samuel-sjoden/drone-project/README.md

# Drone Project
**Attention**
This repository is deprecated and has since been migrated to codeberg: [link here](https://codeberg.org/drone-project)
