samuel-sjoden/drone-project/motor-driver/RP_Minimal/RP2350_QFN80.step

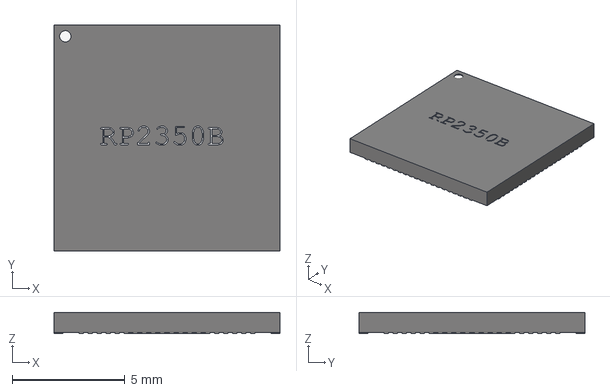
[picture p1: CAD file, 2026-03-13]
motor-driver/RP_Minimal/RP2350_QFN80.step
10.0 x 10.0 x 0.95 mm
