samuel-sjoden/drone-project/motor-driver/RP_Minimal/RP2350_QFN60.step

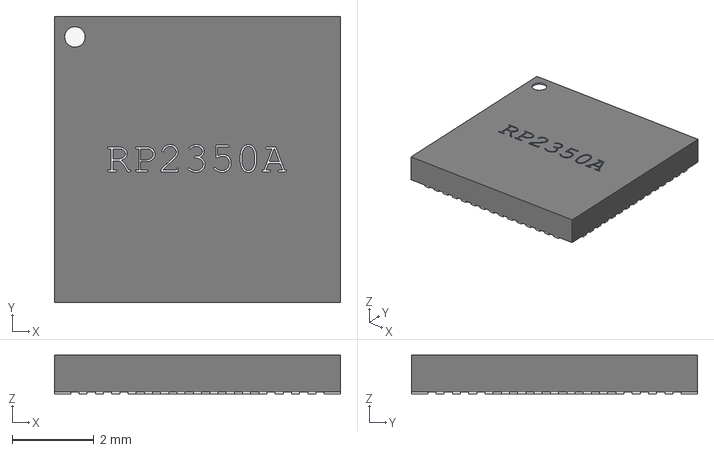
[picture p2: CAD file, 2026-03-13]
motor-driver/RP_Minimal/RP2350_QFN60.step
7.00 x 7.00 x 0.95 mm
