samuel-sjoden/drone-project/motor-driver/motor-driver.kicad_pcb

## KiCad design motor-driver/motor-driver.kicad_pcb (2026-04-12)

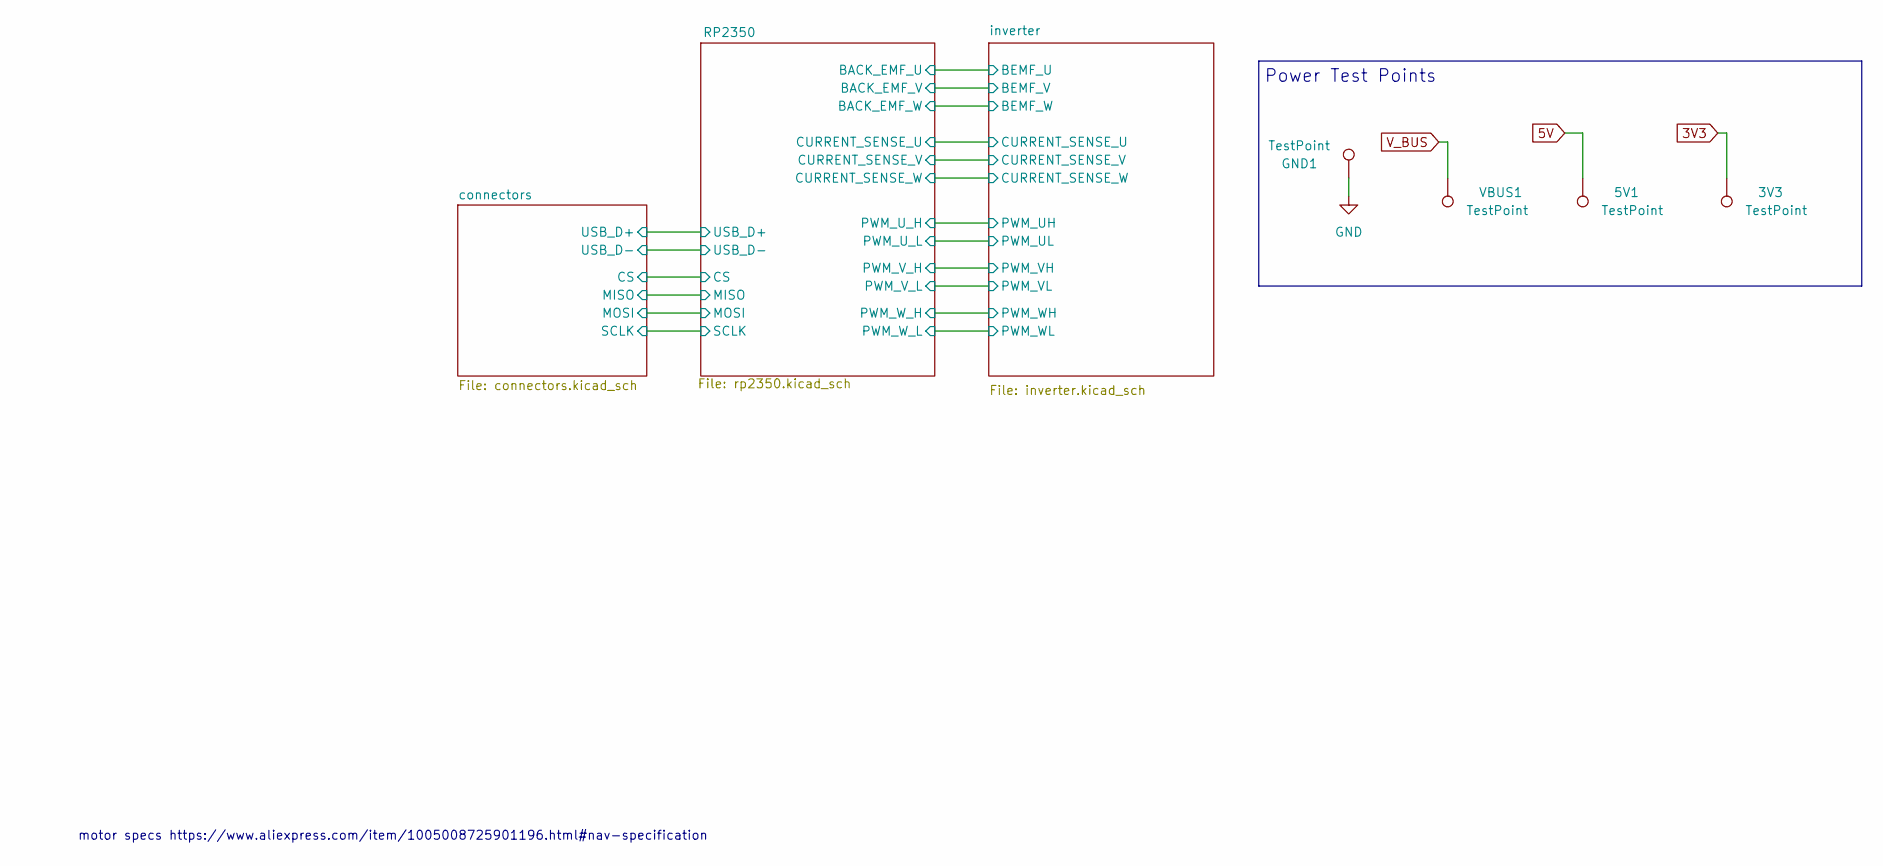
[picture p3: schematic motor-driver.kicad_sch]

Parts:
3V3, 5V1: TestPoint; TestPoint_THTPad_D1.0mm_Drill0.5mm
GND1: TestPoint; TestPoint_THTPad_D1.0mm_Drill0.5mm
VBUS1: TestPoint; TestPoint_THTPad_D1.0mm_Drill0.5mm

Connections:
3V3: 3V3.1; also elsewhere on the board
5V: 5V1.1; also elsewhere on the board
GND: GND1.1; also elsewhere on the board
V_BUS: VBUS1.1; also elsewhere on the board

Notes on the sheet:
motor specs https://www.aliexpress.com/item/1005008725901196.html#nav-specification
Power Test Points

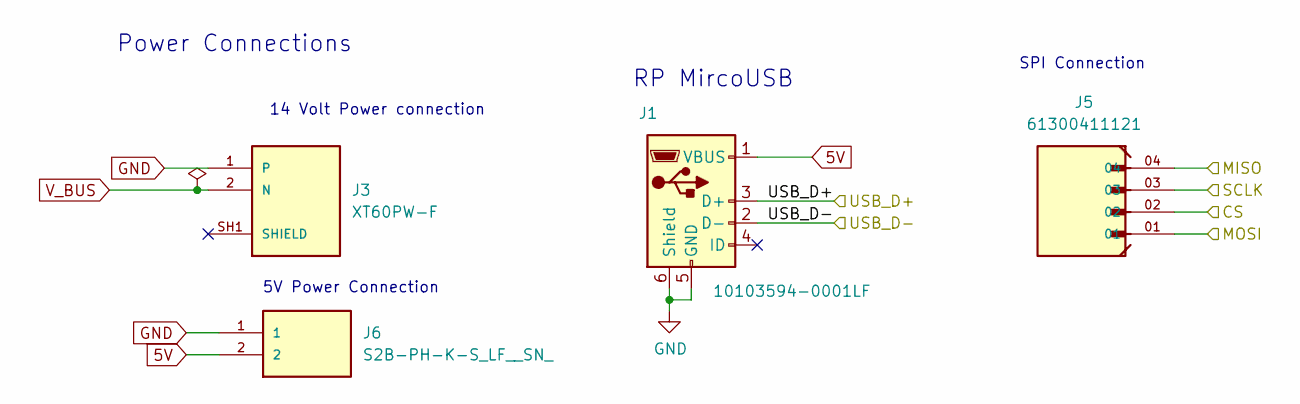
[picture p4: schematic connectors.kicad_sch]

Parts:
J1: 10103594-0001LF; USB_Micro-B_Amphenol_10103594-0001LF_Horizontal; MPN 10103594-0001LF
J3: XT60PW-F; AMASS_XT60PW-F; PARTREV 1.2
J5: 61300411121; WURTH_61300411121; MPN 61300411121
J6: S2B-PH-K-S_LF__SN_; JST_S2B-PH-K-S_LF__SN_

Connections:
5V: J1.1 (VBUS), J6.2; also elsewhere on the board
/RP2350/CS: J5.02; also elsewhere on the board
/RP2350/MISO: J5.04; also elsewhere on the board
/RP2350/MOSI: J5.01; also elsewhere on the board
/RP2350/SCLK: J5.03; also elsewhere on the board
/RP2350/USB_D+: J1.3 (D+); also elsewhere on the board
/RP2350/USB_D-: J1.2 (D-); also elsewhere on the board
GND: J1.5 (GND), J1.6 (Shield), J3.1, J6.1; also elsewhere on the board
V_BUS: J3.2 (N); also elsewhere on the board

Notes on the sheet:
Power Connections
14 Volt Power connection
5V Power Connection
SPI Connection
RP MircoUSB

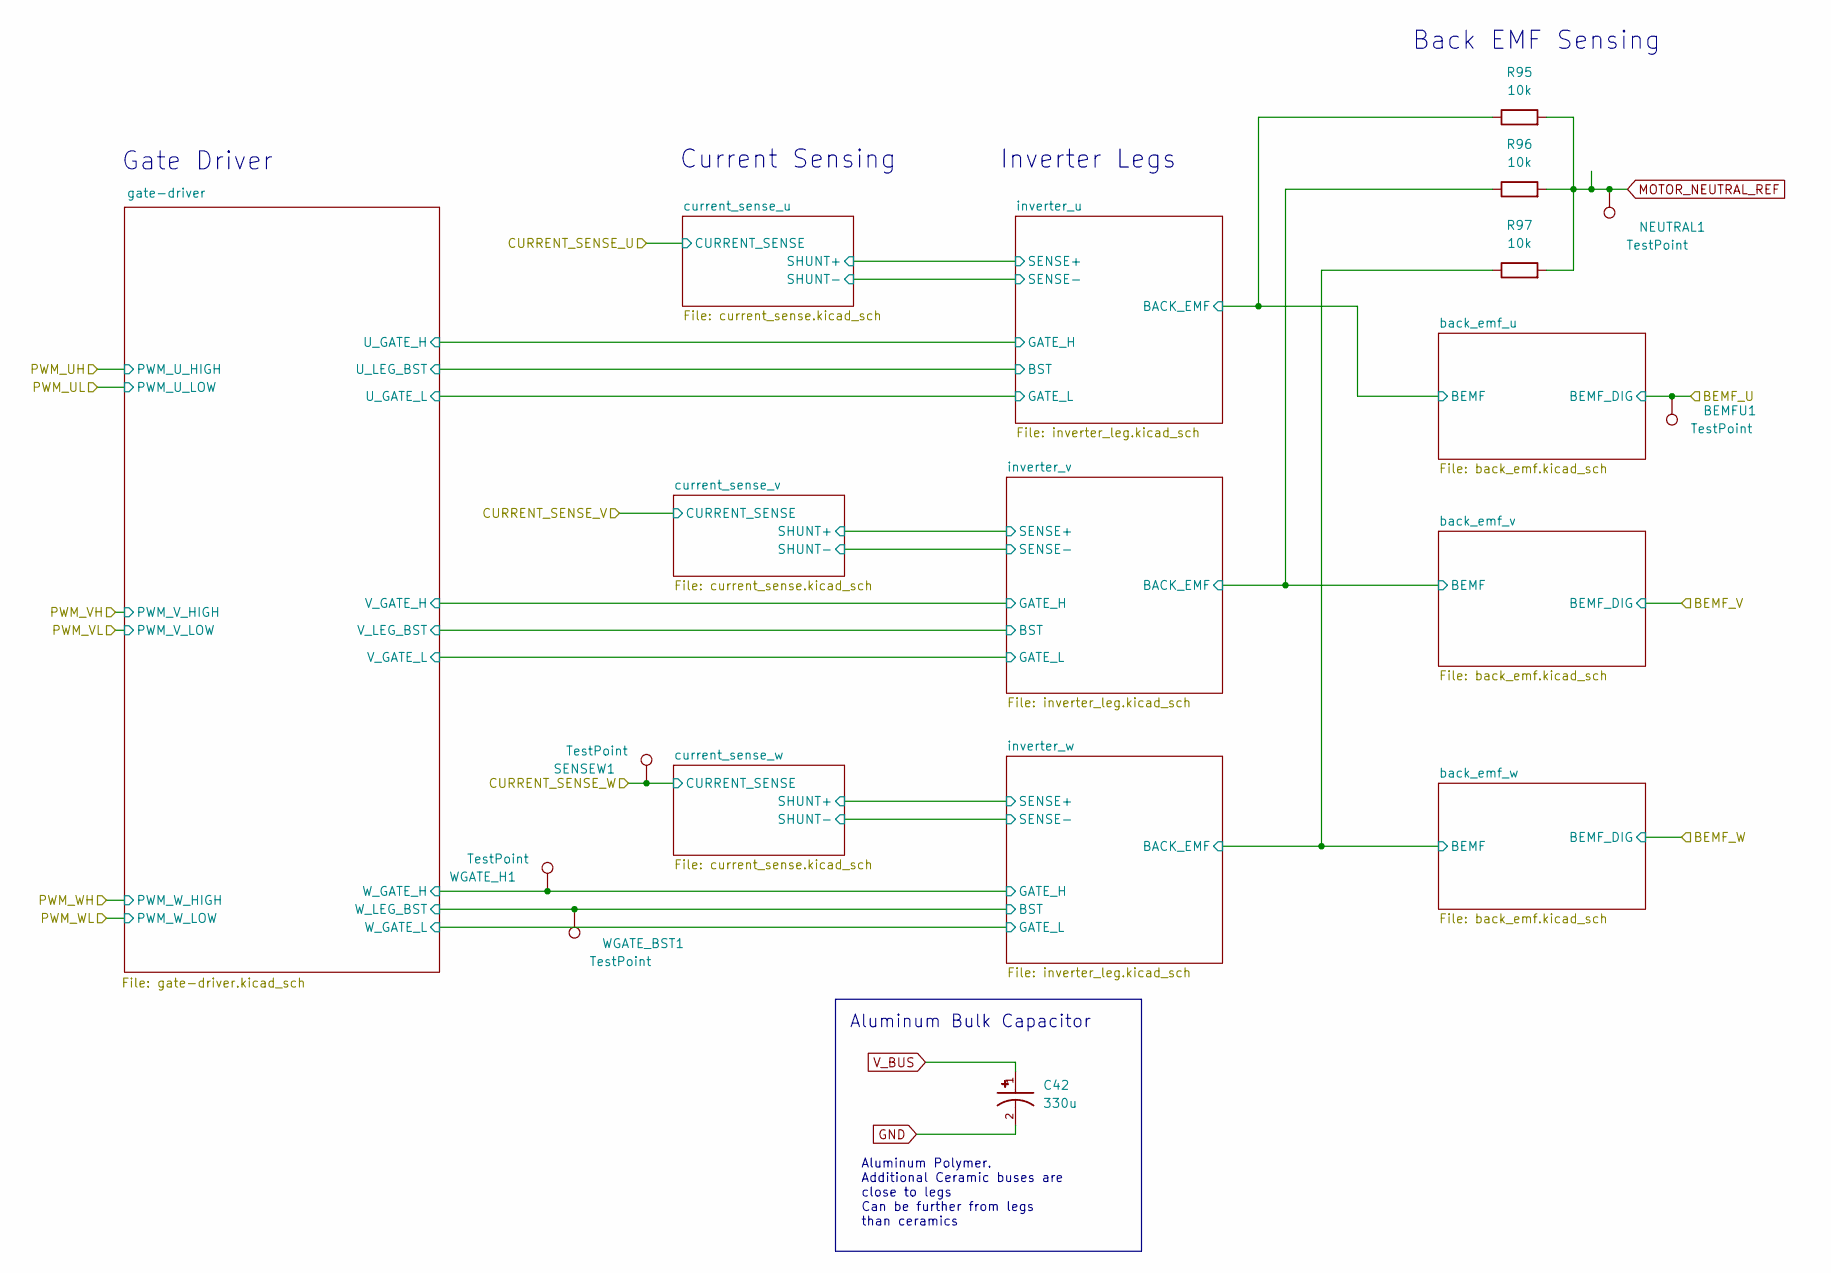
[picture p5: schematic inverter.kicad_sch]

Parts:
BEMFU1: TestPoint; TestPoint_THTPad_D1.0mm_Drill0.5mm
C42: 330u; CAPAE1030X1225N; PARTREV 8/5/2025
NEUTRAL1: TestPoint; TestPoint_THTPad_D1.0mm_Drill0.5mm
R95, R96, R97: 10k; R_0603_1608Metric; MPN RC0603FR-0710KL
SENSEW1: TestPoint; TestPoint_THTPad_D1.0mm_Drill0.5mm
WGATE_BST1: TestPoint; TestPoint_THTPad_D1.0mm_Drill0.5mm
WGATE_H1: TestPoint; TestPoint_THTPad_D1.0mm_Drill0.5mm

Connections:
/RP2350/BACK_EMF_U: BEMFU1.1; also elsewhere on the board
/RP2350/CURRENT_SENSE_W: SENSEW1.1; also elsewhere on the board
/inverter/gate-driver/W_GATE_H: WGATE_H1.1; also elsewhere on the board
/inverter/inverter_u/SHUNT_N: R95.1; also elsewhere on the board
/inverter/inverter_v/SHUNT_N: R96.1; also elsewhere on the board
/inverter/inverter_w/SHUNT_N: R97.1; also elsewhere on the board
/inverter/inverter_w/SHUNT_P: WGATE_BST1.1; also elsewhere on the board
GND: C42.2; also elsewhere on the board
MOTOR_NEUTRAL_REF: NEUTRAL1.1, R95.2, R96.2, R97.2; also elsewhere on the board
V_BUS: C42.1; also elsewhere on the board

Notes on the sheet:
Back EMF Sensing
Current Sensing
Gate Driver
Aluminum Bulk Capacitor
Aluminum Polymer. Additional Ceramic buses are close to legs Can be further from legs than ceramics
Inverter Legs

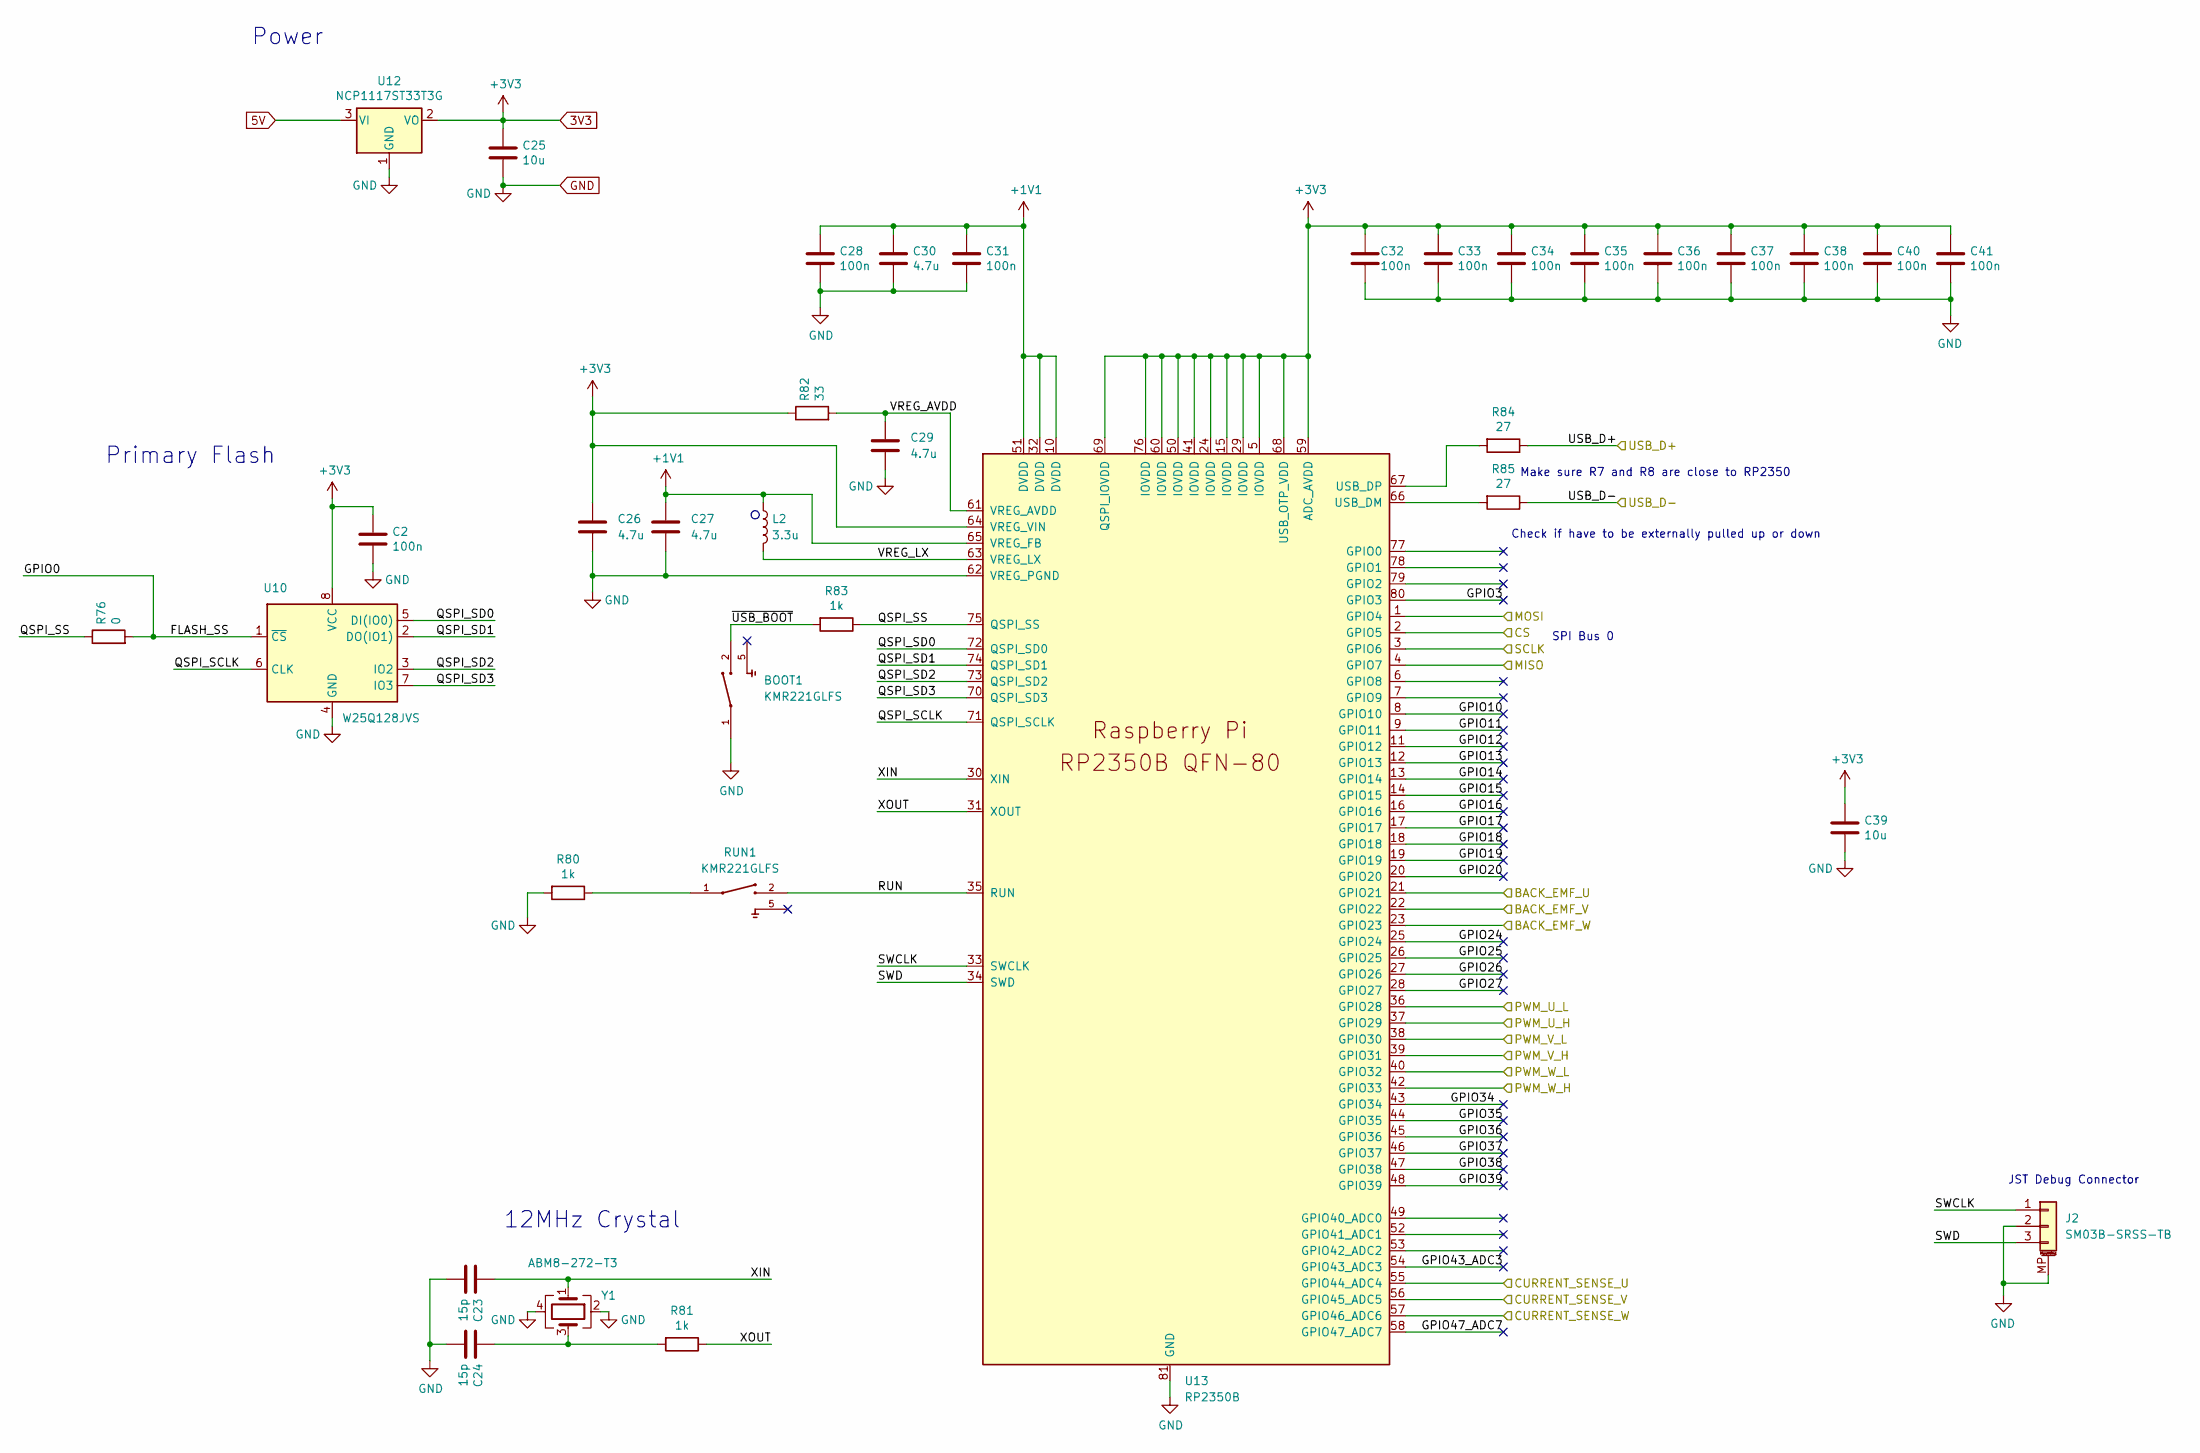
[picture p6: schematic rp2350.kicad_sch, RP2350B QFN80 Minimal Design Example]

Parts:
BOOT1: KMR221GLFS; SW_KMR221GLFS
C2: 100n; C_0603_1608Metric; MPN C0402C104K4RACTU
C23, C24: 15p; C_0402_1005Metric; MPN GJM1555C1H150GB01D
C25, C39: 10u; C_0603_1608Metric; MPN LMK107BBJ106MALT
C26, C27, C29, C30: 4.7u; C_0402_1005Metric; MPN CL05A475MP5NRNC
C28, C31, C32, C33, C34, C35, C36, C37, C38, C40, C41: 100n; C_0402_1005Metric; MPN C0402C104K4RACTU
J2: SM03B-SRSS-TB; JST_SH_SM03B-SRSS-TB_1x03-1MP_P1.00mm_Horizontal; MPN SM03B-SRSS-TB
L2: 3.3u; L_Cenker_CKCS201610; MPN AOTA-B201610S3R3-101-T
R76: 0; R_0603_1608Metric; MPN RC0402JR-070RL
R80, R81, R83: 1k; R_0402_1005Metric; MPN RC0402FR-071KL
R82: 33; R_0402_1005Metric; MPN RC0402JR-0733RL
R84, R85: 27; R_0402_1005Metric; MPN RC0402JR-0727RL
RUN1: KMR221GLFS; SW_KMR221GLFS
U10: W25Q128JVS; SOIC-8_5.23x5.23mm_P1.27mm
U12: NCP1117ST33T3G; SOT-223-3_TabPin2; MPN NCP1117ST33T3G
U13: RP2350B; RP2350-QFN-80-1EP_10x10_P0.4mm_EP3.4x3.4mm_ThermalVias; MPN SC1510-A4
Y1: ABM8-272-T3; Crystal_SMD_3225-4Pin_3.2x2.5mm; MPN ABM8-272-T3

Connections:
3V3: C2.1, C25.1, C26.1, C32.1, C33.1, C34.1, C35.1, C36.1, C37.1, C38.1, C39.1, C40.1, C41.1, R82.1, U10.8 (VCC), U12.2 (VO), U13.5 (IOVDD), U13.15 (IOVDD), U13.24 (IOVDD), U13.29 (IOVDD), U13.41 (IOVDD), U13.50 (IOVDD), U13.59 (ADC_AVDD), U13.60 (IOVDD), U13.64 (VREG_VIN), U13.68 (USB_OTP_VDD), U13.69 (QSPI_IOVDD), U13.76 (IOVDD); also elsewhere on the board
5V: U12.3 (VI); also elsewhere on the board
+1V1: C27.1, C28.1, C30.1, C31.1, L2.1, U13.10 (DVDD), U13.32 (DVDD), U13.51 (DVDD), U13.65 (VREG_FB)
/RP2350/BACK_EMF_U: U13.21 (GPIO21); also elsewhere on the board
/RP2350/BACK_EMF_V: U13.22 (GPIO22); also elsewhere on the board
/RP2350/BACK_EMF_W: U13.23 (GPIO23); also elsewhere on the board
/RP2350/CS: U13.2 (GPIO5); also elsewhere on the board
/RP2350/CURRENT_SENSE_U: U13.55 (GPIO44_ADC4); also elsewhere on the board
/RP2350/CURRENT_SENSE_V: U13.56 (GPIO45_ADC5); also elsewhere on the board
/RP2350/CURRENT_SENSE_W: U13.57 (GPIO46_ADC6); also elsewhere on the board
/RP2350/FLASH_SS: R76.2, U10.1 (~CS)
/RP2350/GPIO3: U13.80 (GPIO3)
/RP2350/GPIO10: U13.8 (GPIO10)
/RP2350/GPIO11: U13.9 (GPIO11)
/RP2350/GPIO12: U13.11 (GPIO12)
/RP2350/GPIO13: U13.12 (GPIO13)
/RP2350/GPIO14: U13.13 (GPIO14)
/RP2350/GPIO15: U13.14 (GPIO15)
/RP2350/GPIO16: U13.16 (GPIO16)
/RP2350/GPIO17: U13.17 (GPIO17)
/RP2350/GPIO18: U13.18 (GPIO18)
/RP2350/GPIO19: U13.19 (GPIO19)
/RP2350/GPIO20: U13.20 (GPIO20)
/RP2350/GPIO24: U13.25 (GPIO24)
/RP2350/GPIO25: U13.26 (GPIO25)
/RP2350/GPIO26: U13.27 (GPIO26)
/RP2350/GPIO27: U13.28 (GPIO27)
/RP2350/GPIO34: U13.43 (GPIO34)
/RP2350/GPIO35: U13.44 (GPIO35)
/RP2350/GPIO36: U13.45 (GPIO36)
/RP2350/GPIO37: U13.46 (GPIO37)
/RP2350/GPIO38: U13.47 (GPIO38)
/RP2350/GPIO39: U13.48 (GPIO39)
/RP2350/GPIO43_ADC3: U13.54 (GPIO43_ADC3)
/RP2350/GPIO47_ADC7: U13.58 (GPIO47_ADC7)
/RP2350/MISO: U13.4 (GPIO7); also elsewhere on the board
/RP2350/MOSI: U13.1 (GPIO4); also elsewhere on the board
/RP2350/PWM_U_H: U13.37 (GPIO29); also elsewhere on the board
/RP2350/PWM_U_L: U13.36 (GPIO28); also elsewhere on the board
/RP2350/PWM_V_H: U13.39 (GPIO31); also elsewhere on the board
/RP2350/PWM_V_L: U13.38 (GPIO30); also elsewhere on the board
/RP2350/PWM_W_H: U13.42 (GPIO33); also elsewhere on the board
/RP2350/PWM_W_L: U13.40 (GPIO32); also elsewhere on the board
/RP2350/QSPI_SCLK: U10.6 (CLK), U13.71 (QSPI_SCLK)
/RP2350/QSPI_SD0: U10.5 (DI(IO0)), U13.72 (QSPI_SD0)
/RP2350/QSPI_SD1: U10.2 (DO(IO1)), U13.74 (QSPI_SD1)
/RP2350/QSPI_SD2: U10.3 (IO2), U13.73 (QSPI_SD2)
/RP2350/QSPI_SD3: U10.7 (IO3), U13.70 (QSPI_SD3)
/RP2350/QSPI_SS: R76.1, R83.1, U13.75 (QSPI_SS)
/RP2350/RUN: RUN1.2, RUN1.3, U13.35 (RUN)
/RP2350/SCLK: U13.3 (GPIO6); also elsewhere on the board
/RP2350/SWCLK: J2.1, U13.33 (SWCLK)
/RP2350/SWD: J2.3, U13.34 (SWD)
/RP2350/USB_D+: R84.1; also elsewhere on the board
/RP2350/USB_D-: R85.1; also elsewhere on the board
/RP2350/VREG_AVDD: C29.1, R82.2, U13.61 (VREG_AVDD)
/RP2350/VREG_LX: L2.2, U13.63 (VREG_LX)
/RP2350/XIN: C23.1, U13.30 (XIN), Y1.1
/RP2350/XOUT: R81.1, U13.31 (XOUT)
/RP2350/~USB_BOOT: BOOT1.2, BOOT1.3, R83.2
GND: BOOT1.1, BOOT1.4, C2.2, C23.2, C24.2, C25.2, C26.2, C27.2, C28.2, C29.2, C30.2, C31.2, C32.2, C33.2, C34.2, C35.2, C36.2, C37.2, C38.2, C39.2, C40.2, C41.2, J2.2, J2.MP (MountPin), R80.2, U10.4 (GND), U12.1 (GND), U13.62 (VREG_PGND), U13.81 (GND), Y1.2, Y1.4; also elsewhere on the board
unnamed: C24.1, R81.2, Y1.3
unnamed: R80.1, RUN1.1, RUN1.4
unnamed: R85.2, U13.66 (USB_DM)
unnamed: R84.2, U13.67 (USB_DP)

Notes on the sheet:
12MHz Crystal
Primary Flash
Check if have to be externally pulled up or down
JST Debug Connector
Make sure R7 and R8 are close to RP2350
Power
SPI Bus 0

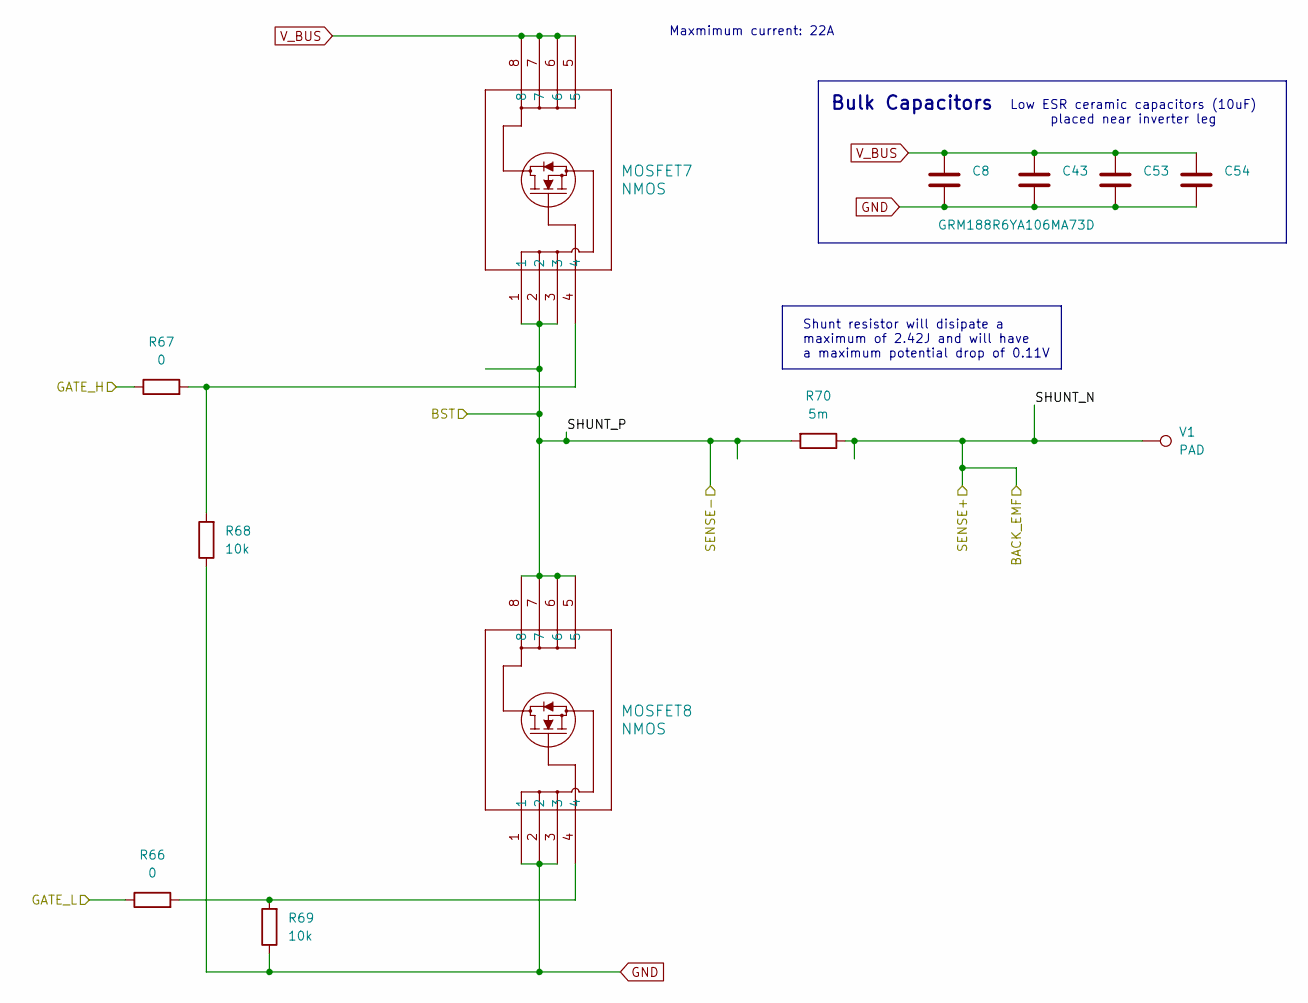
[picture p7: schematic inverter_leg.kicad_sch, Inverter Leg]

Parts:
C8, C43, C53, C54: GRM188R6YA106MA73D; C_0603_1608Metric; MPN GRM188R6YA106MA73D
MOSFET7, MOSFET8: NMOS; DFN5X6_8L_EP1_P_AOS; MPN AON6512
R66, R67: 0; R_0603_1608Metric; MPN RC0603FR-0722RL
R68, R69: 10k; R_0603_1608Metric; MPN RC0603FR-0710KL
R70: 5m; R_2512_6332Metric; MPN CSSU2512FT5L00
V1: PAD; TestPoint_Pad_4.0x4.0mm

Connections:
/inverter/gate-driver/V_GATE_H: R67.1; also elsewhere on the board
/inverter/gate-driver/V_GATE_L: R66.1; also elsewhere on the board
/inverter/inverter_v/SHUNT_N: R70.1, V1.1; also elsewhere on the board
/inverter/inverter_v/SHUNT_P: MOSFET7.1, MOSFET7.2, MOSFET7.3, MOSFET8.5, MOSFET8.6, MOSFET8.7, MOSFET8.8, R70.2; also elsewhere on the board
GND: C8.2, C43.2, C53.2, C54.2, MOSFET8.1, MOSFET8.2, MOSFET8.3, R68.1, R69.1; also elsewhere on the board
unnamed: MOSFET7.4, R67.2, R68.2
unnamed: MOSFET8.4, R66.2, R69.2
V_BUS: C8.1, C43.1, C53.1, C54.1, MOSFET7.5, MOSFET7.6, MOSFET7.7, MOSFET7.8; also elsewhere on the board

Parts of its further copies:
C55, C56, C57, C58, C59, C60, C61, C62: GRM188R6YA106MA73D; C_0603_1608Metric; MPN GRM188R6YA106MA73D
MOSFET1, MOSFET2, MOSFET9, MOSFET10: NMOS; DFN5X6_8L_EP1_P_AOS; MPN AON6512
R6, R27, R71, R86: 0; R_0603_1608Metric; MPN RC0603FR-0722RL
R26, R28, R87, R88: 10k; R_0603_1608Metric; MPN RC0603FR-0710KL
R29, R89: 5m; R_2512_6332Metric; MPN CSSU2512FT5L00
U1: PAD; TestPoint_Pad_4.0x4.0mm
W1: PAD; TestPoint_Pad_4.0x4.0mm

Connections of its further copies:
/inverter/gate-driver/U_GATE_H: R6.1; also elsewhere on the board
/inverter/gate-driver/U_GATE_L: R27.1; also elsewhere on the board
/inverter/gate-driver/W_GATE_H: R86.1; also elsewhere on the board
/inverter/gate-driver/W_GATE_L: R71.1; also elsewhere on the board
/inverter/inverter_u/SHUNT_N: R29.1, U1.1; also elsewhere on the board
/inverter/inverter_u/SHUNT_P: MOSFET1.1, MOSFET1.2, MOSFET1.3, MOSFET2.5, MOSFET2.6, MOSFET2.7, MOSFET2.8, R29.2; also elsewhere on the board
/inverter/inverter_w/SHUNT_N: R89.1, W1.1; also elsewhere on the board
/inverter/inverter_w/SHUNT_P: MOSFET9.1, MOSFET9.2, MOSFET9.3, MOSFET10.5, MOSFET10.6, MOSFET10.7, MOSFET10.8, R89.2; also elsewhere on the board
GND: C55.2, C56.2, C57.2, C58.2, C59.2, C60.2, C61.2, C62.2, MOSFET2.1, MOSFET2.2, MOSFET2.3, MOSFET10.1, MOSFET10.2, MOSFET10.3, R26.1, R28.1, R87.1, R88.1; also elsewhere on the board
unnamed: MOSFET1.4, R6.2, R26.2
unnamed: MOSFET2.4, R27.2, R28.2
unnamed: MOSFET9.4, R86.2, R87.2
unnamed: MOSFET10.4, R71.2, R88.2
V_BUS: C55.1, C56.1, C57.1, C58.1, C59.1, C60.1, C61.1, C62.1, MOSFET1.5, MOSFET1.6, MOSFET1.7, MOSFET1.8, MOSFET9.5, MOSFET9.6, MOSFET9.7, MOSFET9.8; also elsewhere on the board

Notes on the sheet:
Maxmimum current: 22A
Bulk Capacitors
Shunt resistor will disipate a maximum of 2.42J and will have a maximum potential drop of 0.11V
Low ESR ceramic capacitors (10uF) placed near inverter leg

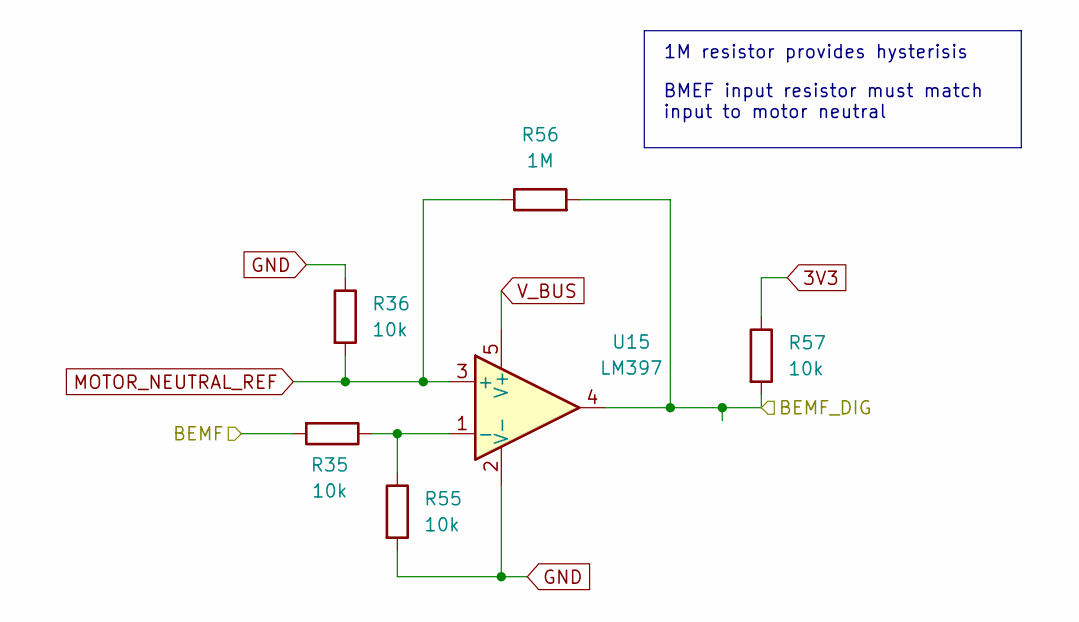
[picture p8: schematic back_emf.kicad_sch]

Parts:
R35, R36, R55, R57: 10k; R_0603_1608Metric; MPN RC0603FR-0710KL
R56: 1M; R_0603_1608Metric; MPN RC0603FR-071ML
U15: LM397; SOT-23-5; MPN LM397MFX/NOPB

Connections:
3V3: R57.1; also elsewhere on the board
/RP2350/BACK_EMF_V: R56.2, R57.2, U15.4; also elsewhere on the board
/inverter/inverter_v/SHUNT_N: R35.2; also elsewhere on the board
GND: R36.1, R55.2, U15.2 (V-); also elsewhere on the board
MOTOR_NEUTRAL_REF: R36.2, R56.1, U15.3 (+); also elsewhere on the board
unnamed: R35.1, R55.1, U15.1 (-)
V_BUS: U15.5 (V+); also elsewhere on the board

Parts of its further copies:
R30, R31, R32, R34, R90, R91, R92, R94: 10k; R_0603_1608Metric; MPN RC0603FR-0710KL
R33, R93: 1M; R_0603_1608Metric; MPN RC0603FR-071ML
U14, U16: LM397; SOT-23-5; MPN LM397MFX/NOPB

Connections of its further copies:
3V3: R34.1, R94.1; also elsewhere on the board
/RP2350/BACK_EMF_U: R33.2, R34.2, U14.4; also elsewhere on the board
/RP2350/BACK_EMF_W: R93.2, R94.2, U16.4; also elsewhere on the board
/inverter/inverter_u/SHUNT_N: R30.2; also elsewhere on the board
/inverter/inverter_w/SHUNT_N: R90.2; also elsewhere on the board
GND: R31.1, R32.2, R91.1, R92.2, U14.2 (V-), U16.2 (V-); also elsewhere on the board
MOTOR_NEUTRAL_REF: R31.2, R33.1, R91.2, R93.1, U14.3 (+), U16.3 (+); also elsewhere on the board
unnamed: R30.1, R32.1, U14.1 (-)
unnamed: R90.1, R92.1, U16.1 (-)
V_BUS: U14.5 (V+), U16.5 (V+); also elsewhere on the board

Notes on the sheet:
1M resistor provides hysterisis
BMEF input resistor must match input to motor neutral

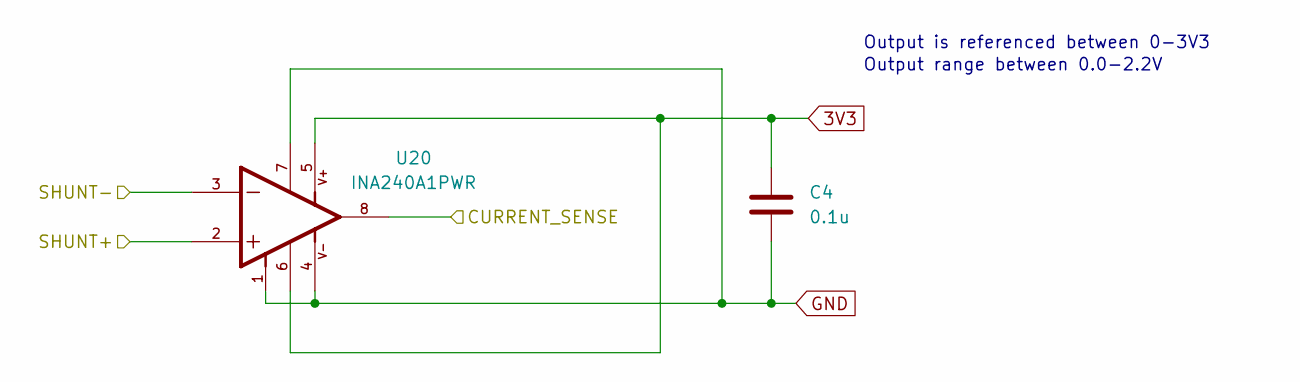
[picture p9: schematic current_sense.kicad_sch]

Parts:
C4: 0.1u; C_0603_1608Metric; MPN C0603C104K5RACTU
U20: INA240A1PWR; SOP65P640X120-8N; PARTREV C

Connections:
3V3: C4.1, U20.5, U20.6; also elsewhere on the board
/RP2350/CURRENT_SENSE_V: U20.8; also elsewhere on the board
/inverter/inverter_v/SHUNT_N: U20.2; also elsewhere on the board
/inverter/inverter_v/SHUNT_P: U20.3; also elsewhere on the board
GND: C4.2, U20.1, U20.4, U20.7; also elsewhere on the board

Parts of its further copies:
C3, C5: 0.1u; C_0603_1608Metric; MPN C0603C104K5RACTU
U19, U21: INA240A1PWR; SOP65P640X120-8N; PARTREV C

Connections of its further copies:
3V3: C3.1, C5.1, U19.5, U19.6, U21.5, U21.6; also elsewhere on the board
/RP2350/CURRENT_SENSE_U: U19.8; also elsewhere on the board
/RP2350/CURRENT_SENSE_W: U21.8; also elsewhere on the board
/inverter/inverter_u/SHUNT_N: U19.2; also elsewhere on the board
/inverter/inverter_u/SHUNT_P: U19.3; also elsewhere on the board
/inverter/inverter_w/SHUNT_N: U21.2; also elsewhere on the board
/inverter/inverter_w/SHUNT_P: U21.3; also elsewhere on the board
GND: C3.2, C5.2, U19.1, U19.4, U19.7, U21.1, U21.4, U21.7; also elsewhere on the board

Notes on the sheet:
Output is referenced between 0-3V3
Output range between 0.0-2.2V

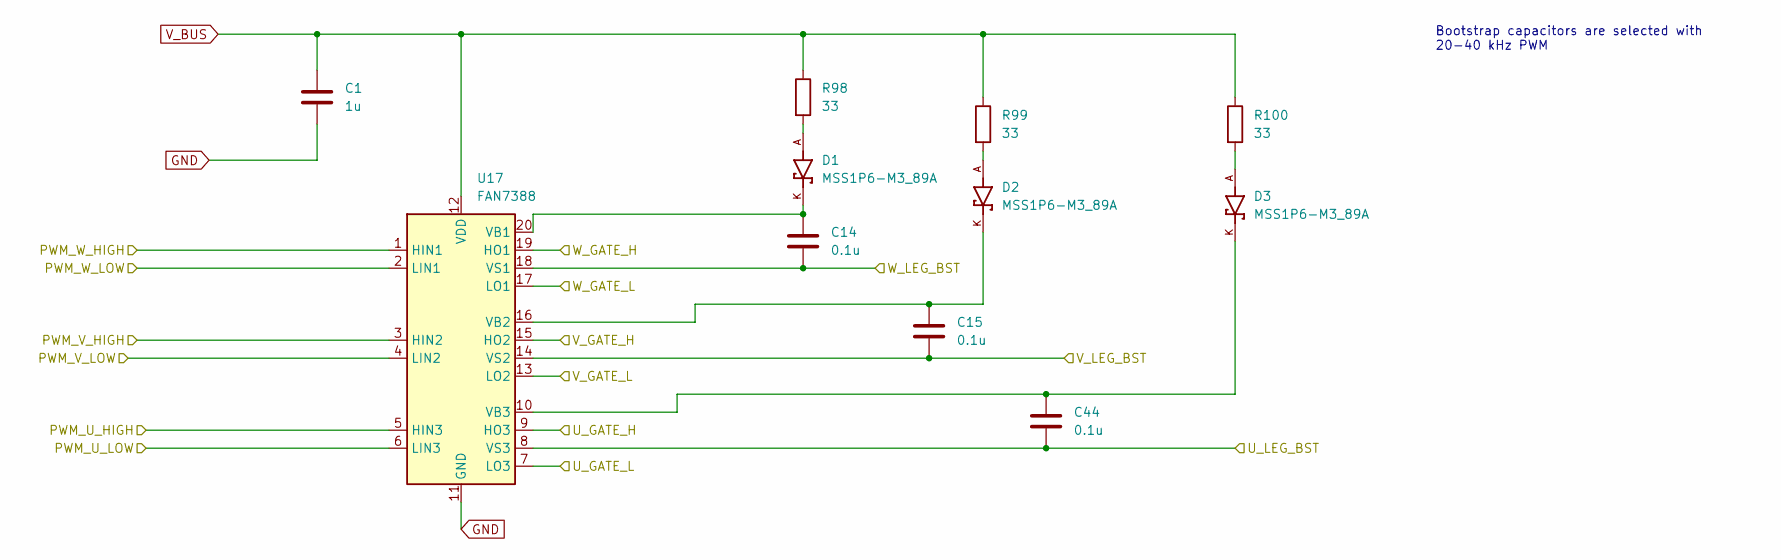
[picture p10: schematic gate-driver.kicad_sch]

Parts:
C1: 1u; C_0603_1608Metric; MPN C0603C105K4RACTU
C14, C15, C44: 0.1u; C_0603_1608Metric; MPN C0603C104K5RACTU
D1, D2, D3: MSS1P6-M3_89A; DIO_MSS1P6-M3_89A; PARTREV 03-Aug-2020
R98, R99, R100: 33; R_0603_1608Metric; MPN RC0603FR-0733RL
U17: FAN7388; SOIC-20W_7.5x12.8mm_P1.27mm; MPN FAN7388MX

Connections:
/RP2350/PWM_U_H: U17.5 (HIN3); also elsewhere on the board
/RP2350/PWM_U_L: U17.6 (LIN3); also elsewhere on the board
/RP2350/PWM_V_H: U17.3 (HIN2); also elsewhere on the board
/RP2350/PWM_V_L: U17.4 (LIN2); also elsewhere on the board
/RP2350/PWM_W_H: U17.1 (HIN1); also elsewhere on the board
/RP2350/PWM_W_L: U17.2 (LIN1); also elsewhere on the board
/inverter/gate-driver/U_GATE_H: U17.9 (HO3); also elsewhere on the board
/inverter/gate-driver/U_GATE_L: U17.7 (LO3); also elsewhere on the board
/inverter/gate-driver/V_GATE_H: U17.15 (HO2); also elsewhere on the board
/inverter/gate-driver/V_GATE_L: U17.13 (LO2); also elsewhere on the board
/inverter/gate-driver/W_GATE_H: U17.19 (HO1); also elsewhere on the board
/inverter/gate-driver/W_GATE_L: U17.17 (LO1); also elsewhere on the board
/inverter/inverter_u/SHUNT_P: C44.1, U17.8 (VS3); also elsewhere on the board
/inverter/inverter_v/SHUNT_P: C15.1, U17.14 (VS2); also elsewhere on the board
/inverter/inverter_w/SHUNT_P: C14.1, U17.18 (VS1); also elsewhere on the board
GND: C1.2, U17.11 (GND); also elsewhere on the board
unnamed: D1.A, R98.2
unnamed: D2.A, R99.2
unnamed: D3.A, R100.2
unnamed: C14.2, D1.K, U17.20 (VB1)
unnamed: C15.2, D2.K, U17.16 (VB2)
unnamed: C44.2, D3.K, U17.10 (VB3)
V_BUS: C1.1, R98.1, R99.1, R100.1, U17.12 (VDD); also elsewhere on the board

Notes on the sheet:
Bootstrap capacitors are selected with 20-40 kHz PWM

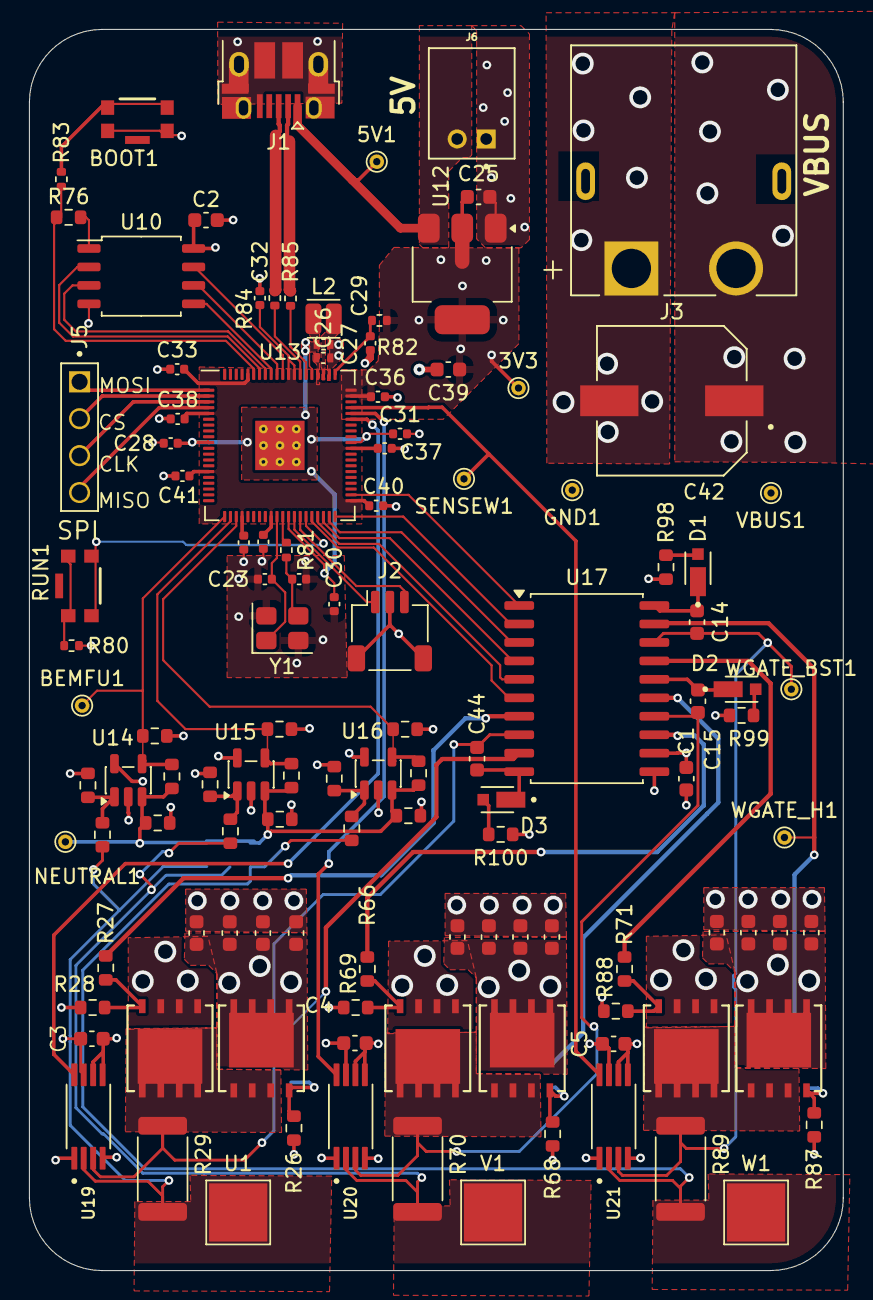
[picture p11: board motor-driver.kicad_pcb from above]

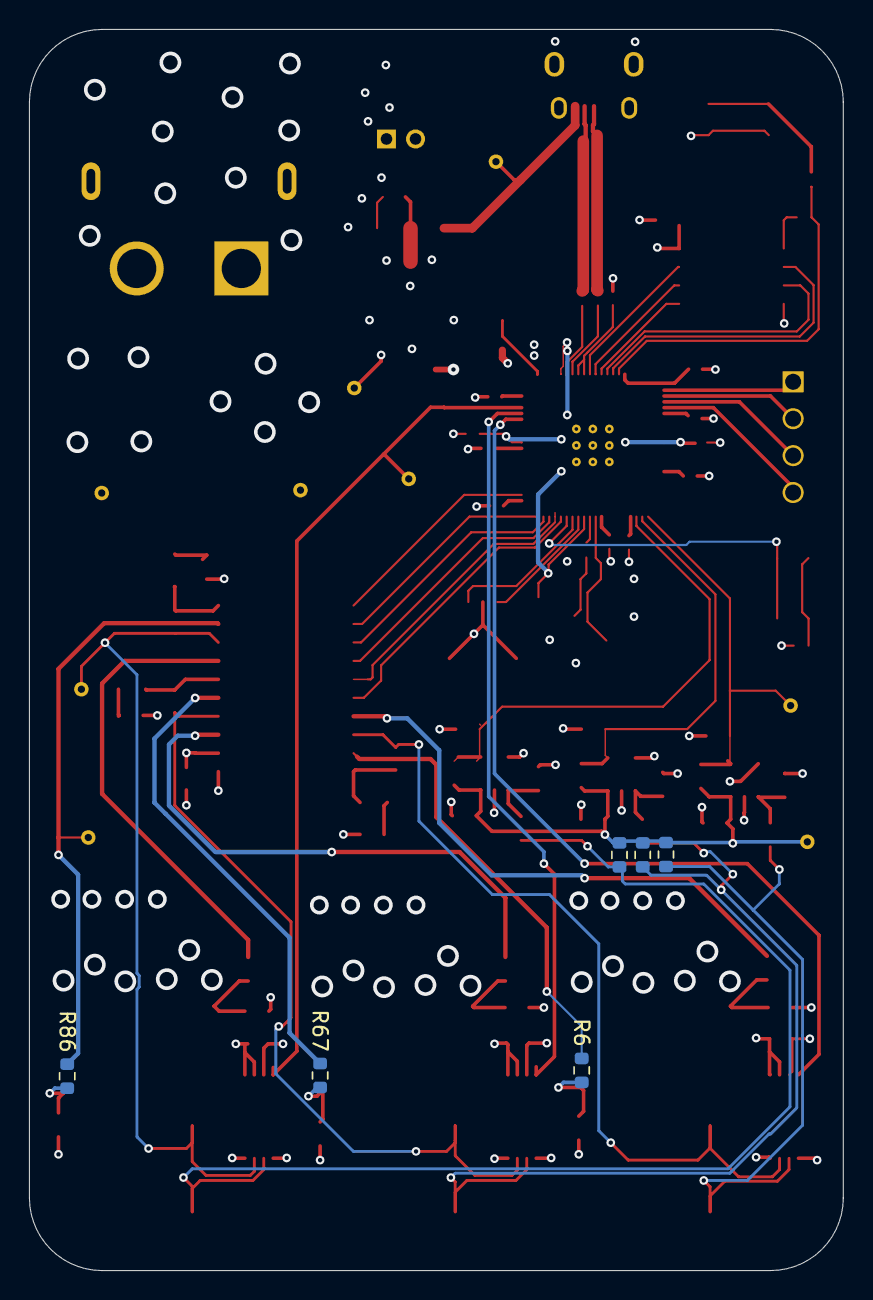
[picture p12: board motor-driver.kicad_pcb from below]

Board: 4 copper layers, 56.0 x 85.4 mm, 123 parts (6 on the bottom side), 70 nets.
