samuel-sjoden/drone-project/flight-controller/flight-controller.kicad_pcb

## KiCad design flight-controller/flight-controller.kicad_pcb (2026-04-12)

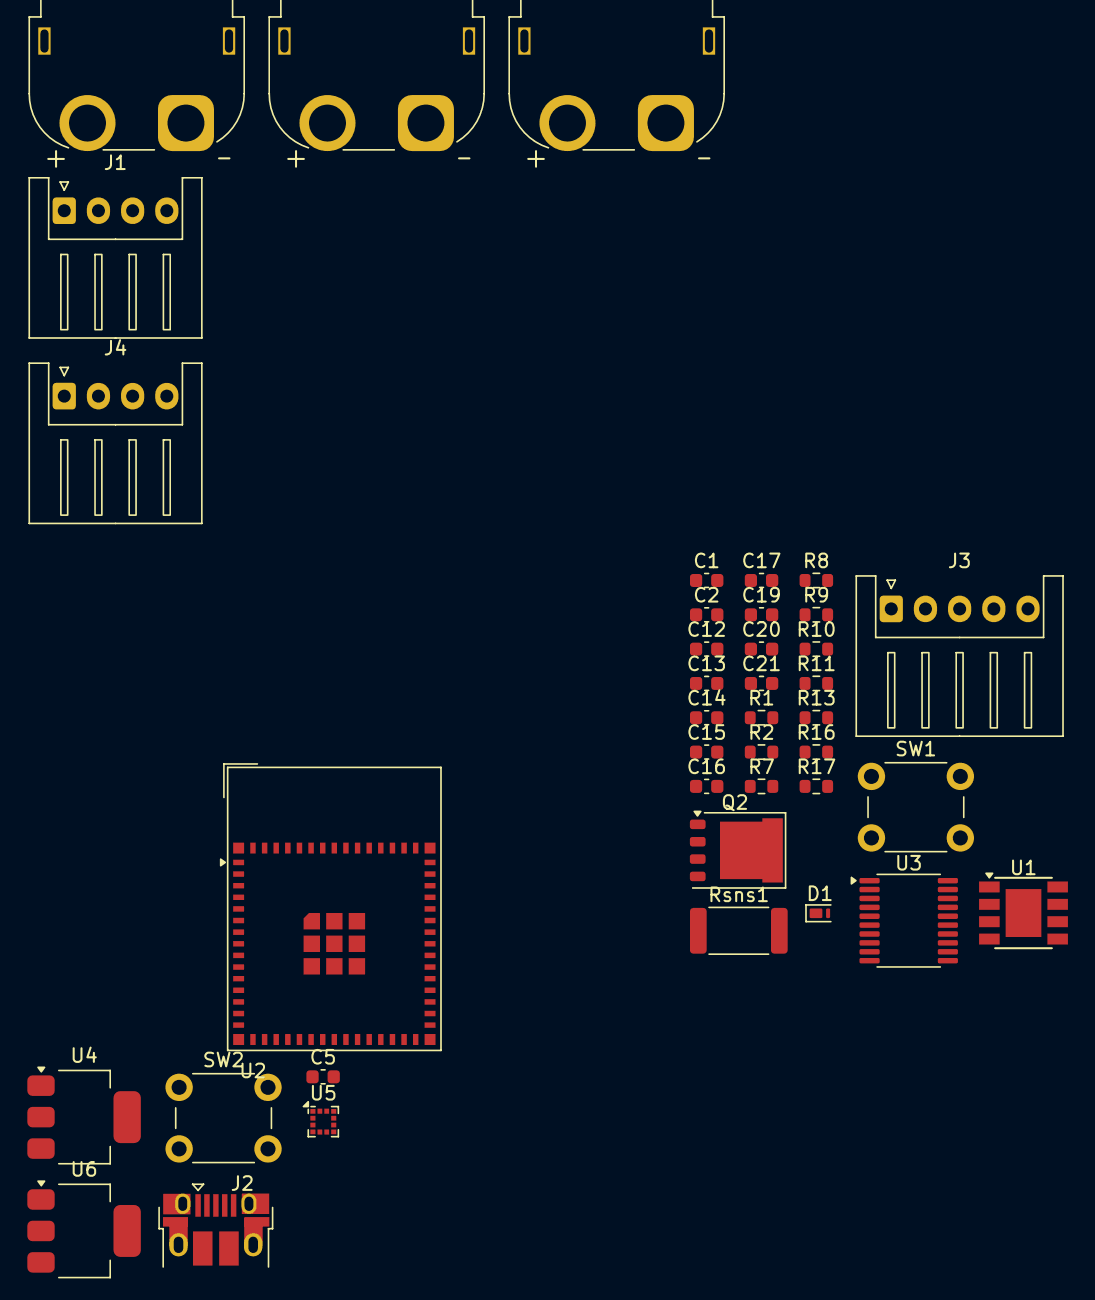
[picture p13: board flight-controller.kicad_pcb from above]

Board: 2 copper layers, 40 parts (0 on the bottom side), 35 nets, no tracks yet.

Parts:
C1, C12, C16, C17, C19, C20, C21: 1u; C_0603_1608Metric
C2, C5: 10u; C_0603_1608Metric
C13, C14, C15: 0.1u; C_0603_1608Metric
D1: PTVS18VZ1USK; Nexperia_DSN1608-2_1.6x0.8mm
J1: MD1_SPI; JST_XH_S4B-XH-A_1x04_P2.50mm_Horizontal
J2: USB_B_Micro; USB_Micro-B_Amphenol_10103594-0001LF_Horizontal
J3: Lipo JST; JST_XH_S5B-XH-A_1x05_P2.50mm_Horizontal
J4: MD2_SPI; JST_XH_S4B-XH-A_1x04_P2.50mm_Horizontal
J8: XT60PW-F; AMASS_XT60PW-F_1x02_P7.20mm_Horizontal
J9: MD1_15V; AMASS_XT60PW-F_1x02_P7.20mm_Horizontal
J10: MD2_15V; AMASS_XT60PW-F_1x02_P7.20mm_Horizontal
Q2: NMOS; PQFN-8-EP_6x5mm_P1.27mm_Generic
R1, R2, R9, R10, R11, R13, R16: 100; R_0603_1608Metric
R7: 1M; R_0603_1608Metric
R8, R17: 10k; R_0603_1608Metric
Rsns1: 5m; R_2512_6332Metric
SW1: SW_Push; SW_PUSH_6mm
SW2: RESET; SW_PUSH_6mm
U1: AP64500SP-13; Diodes_SO-8EP
U2: ESP32-S3-MINI-1; ESP32-S2-MINI-1
U3: BQ76920PW; TSSOP-20_4.4x6.5mm_P0.65mm
U4: NCP1117ST33T3G; SOT-223-3_TabPin2
U5: LIS2MDL; LGA-12_2x2mm_P0.5mm
U6: NCP1117-1.8_SOT223; SOT-223-3_TabPin2

Connections:
3V3: C5.1, U2.3 (3V3), U4.2 (VO)
5V: J2.1 (VBUS), U4.3 (VI), U6.3 (VI)
+1V8: U5.9 (Vdd), U5.10 (Vdd_IO), U6.2 (VO)
/BMS/15V: C12.1, D1.1 (K), J8.1, J9.1, J10.1, R1.1, U1.2 (VIN), U1.3 (EN), U3.9 (REGSRC)
/BMS/INT_BMS: U2.10 (IO6), U3.20 (ALERT)
/BMS/PWR_BTN: R8.1, R17.1, U2.5 (IO1), U3.6 (TS1)
/Flight_Controller/CS_MD1: J1.3, U2.31 (IO35)
/Flight_Controller/CS_MD2: J4.3, U2.32 (IO36)
/Flight_Controller/MISO: J1.1, J4.1, U2.17 (IO13)
/Flight_Controller/MOSI: J1.4, J4.4, U2.15 (IO11)
/Flight_Controller/SCL: U2.12 (IO8), U3.5 (SCL)
/Flight_Controller/SCLK: J1.2, J4.2, U2.16 (IO12)
/Flight_Controller/SDA: U2.13 (IO9), U3.4 (SDA)
GND: C1.2, C2.2, C12.2, C14.1, C15.2, C16.2, C17.1, J8.2 (N), R8.2, R11.1, Rsns1.1, U3.3 (VSS)
GND1: C5.2, D1.2 (A), J2.5 (GND), J2.SH (Shield), J9.2 (N), J10.2 (N), Q2.1 (D), SW2.1, U1.7 (GND), U2.1 (GND), U2.2 (GND), U2.42 (GND), U2.43 (GND), U2.46 (GND), U2.47 (GND), U2.48 (GND), U2.49 (GND), U2.50 (GND), U2.51 (GND), U2.52 (GND), U2.53 (GND), U2.54 (GND), U2.55 (GND), U2.56 (GND), U2.57 (GND), U2.58 (GND), U2.59 (GND), U2.60 (GND), U2.61 (GND), U2.62 (GND), U2.63 (GND), U2.64 (GND), U2.65 (GND), U4.1 (GND), U5.6 (GND), U5.8 (GND), U6.1 (GND)
unnamed: J2.3 (D+), U2.24 (USB_D+)
unnamed: J2.2 (D-), U2.23 (USB_D-)
unnamed: J3.1, R9.1
unnamed: J3.2, R10.1
unnamed: J3.3, R13.1
unnamed: J3.4, R2.1
unnamed: J3.5, R16.1
unnamed: Q2.2 (G), R7.1, U3.1 (DSG)
unnamed: Q2.3 (S), R7.2, Rsns1.2
unnamed: R17.2, SW1.1
unnamed: SW2.2, U2.45 (EN)
unnamed: C2.1, R1.2, U3.10 (BAT)
unnamed: C1.1, U3.7 (CAP1)
unnamed: C13.1, C14.2, U3.19 (SRN)
unnamed: C13.2, C15.1, R11.2, U3.18 (SRP)
unnamed: C17.2, R9.2, U3.17 (VC0)
unnamed: C16.1, C19.2, R10.2, SW1.2, U3.16 (VC1)
unnamed: C19.1, C20.2, R13.2, U3.15 (VC2)
unnamed: C20.1, C21.2, R2.2, U3.13 (VC4), U3.14 (VC3)
unnamed: C21.1, R16.2, U3.12 (VC5)
