samuel-sjoden/drone-project/software/open-loop/main/foc/sin_lut.c

#include "foc.h"

const float sin_lut[LUT_SIZE] = {
    0.0000,

    0.0077,

    0.0153,

    0.0230,

    0.0307,

    0.0383,

    0.0460,

    0.0537,

    0.0613,

    0.0690,

    0.0766,

    0.0843,

    0.0919,

    0.0995,

    0.1072,

    0.1148,

    0.1224,

    0.1300,

    0.1376,

    0.1452,

    0.1528,

    0.1604,

    0.1679,

    0.1755,

    0.1830,

    0.1906,

    0.1981,

    0.2056,

    0.2131,

    0.2206,

    0.2281,

    0.2355,

    0.2430,

    0.2504,

    0.2578,

    0.2652,

    0.2726,

    0.2800,

    0.2873,

    0.2947,

    0.3020,

    0.3093,

    0.3166,

    0.3239,

    0.3311,

    0.3383,

    0.3455,

    0.3527,

    0.3599,

    0.3670,

    0.3742,

    0.3813,

    0.3883,

    0.3954,

    0.4024,

    0.4094,

    0.4164,

    0.4234,

    0.4303,

    0.4372,

    0.4441,

    0.4510,

    0.4578,

    0.4646,

    0.4714,

    0.4781,

    0.4849,

    0.4916,

    0.4982,

    0.5049,

    0.5115,

    0.5180,

    0.5246,

    0.5311,

    0.5376,

    0.5440,

    0.5505,

    0.5568,

    0.5632,

    0.5695,

    0.5758,

    0.5821,

    0.5883,

    0.5945,

    0.6006,

    0.6067,

    0.6128,

    0.6189,

    0.6249,

    0.6308,

    0.6368,

    0.6427,

    0.6485,

    0.6543,

    0.6601,

    0.6659,

    0.6716,

    0.6772,

    0.6828,

    0.6884,

    0.6940,

    0.6995,

    0.7049,

    0.7104,

    0.7157,

    0.7211,

    0.7264,

    0.7316,

    0.7368,

    0.7420,

    0.7471,

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

    0.9858,

    0.9871,

    0.9883,

    0.9894,

    0.9905,

    0.9915,

    0.9925,

    0.9934,

    0.9942,

    0.9950,

    0.9958,

    0.9964,

    0.9971,

    0.9976,

    0.9981,

    0.9986,

    0.9989,

    0.9993,

    0.9995,

    0.9997,

    0.9999,

    1.0000,

};
