samuel-sjoden/drone-project/(commit log)

2026-01-16 fixed gitignore
    [motor-driver.kicad_pcb, motor-driver.kicad_sch]
2026-01-17 fix to espressif api call
    [open-loop.c]
2026-02-19 software pwm with edge triggered calculations
2026-02-23 fixed linking and logic bugs with sine look up table
    [app_main.c, foc.h, sin_lut.c]
2026-02-23 fixed bugs with testing
    [app_main.c, inverter.c, inverter.h]
2026-02-24 Testing commit
    [motor-driver.kicad_sch]
2026-02-27 motor driver schematic updated
    [motor-driver.kicad_sch]
2026-02-27 modified bulk capacitor setup
    [motor-driver.kicad_sch]
2026-03-09 current sense finshed for motor driver
    [back_emf_sensing.kicad_sch, current-sense.kicad_sch, motor-driver.kicad_sch, rp2350.kicad_sch]
2026-03-10 completed sheet connections
    [back_emf_sensing.kicad_sch, current-sense.kicad_sch, gate-driver.kicad_sch, inverter.kicad_sch, motor-driver.kicad_sch, rp2350.kicad_sch]
2026-03-13 added connectors starting pcb layout
    [RP2350_80QFN_minimal.kicad_pcb, RP2350_80QFN_minimal.kicad_sch, RP2350_80QFN_minimal.sch, RP2350_QFN60.step, RP2350_QFN80.step, back_emf_sensing.kicad_sch, connectors.kicad_sch, current-sense.kicad_sch]
2026-03-25 commit before changing custom sullen key sense
    [Power Board.kicad_pcb, Power Board.kicad_sch, back_emf_sensing.kicad_sch, current-sense.kicad_sch, gate-driver.kicad_sch, inverter.kicad_sch, motor-driver.kicad_pcb, rp2350.kicad_sch]
2026-03-27 commit before inverter revisions
    [inverter.kicad_sch]
2026-03-27 post revisions
    [back_emf.kicad_sch, back_emf_sensing.kicad_sch, connectors.kicad_sch, current-sense.kicad_sch, current_sense.kicad_sch, gate-driver.kicad_sch, inverter.kicad_sch, inverter_leg.kicad_sch]
2026-03-30 routing complete
    [connectors.kicad_sch, current_sense.kicad_sch, gate-driver.kicad_sch, inverter.kicad_sch, inverter_leg.kicad_sch, motor-driver.kicad_pcb]
2026-04-01 added spi connection
    [back_emf.kicad_sch, bom.csv, connectors.kicad_sch, current_sense.kicad_sch, designators.csv, gate-driver.kicad_sch, inverter.kicad_sch, inverter_leg.kicad_sch]
2026-04-01 board ready for review
    [motor-driver.kicad_pcb]
2026-04-01 added test points
    [back_emf.kicad_sch, current_sense.kicad_sch, gate-driver.kicad_sch, inverter.kicad_sch, inverter_leg.kicad_sch, motor-driver.kicad_pcb, motor-driver.kicad_sch]
2026-04-02 bom finished
    [back_emf.kicad_sch, connectors.kicad_sch, current_sense.kicad_sch, gate-driver.kicad_sch, inverter.kicad_sch, inverter_leg.kicad_sch, motor-driver.kicad_pcb, motor-driver.kicad_sch]
2026-04-03 deleted cache
    [Power Board.kicad_pcb, Power Board.kicad_sch]
2026-04-03 changed push buttons and zone clearances
    [connectors.kicad_sch, inverter.kicad_sch, inverter_leg.kicad_sch, motor-driver.kicad_pcb, motor-driver_V0.0_bom.csv, motor-driver_V0.0_designators.csv, motor-driver_V0.0_positions.csv, rp2350.kicad_sch]
2026-04-04 clean hierachy?
    [BMS.kicad_sch, FC.kicad_sch, Flight_Controller.kicad_sch, Power Board.kicad_pcb, Power Board.kicad_sch, untitled.kicad_sch]
2026-04-04 clean hierachy
    [BMS.kicad_sch, FC.kicad_sch, Flight_Controller.kicad_sch, Power Board.kicad_pcb, Power Board.kicad_sch, flight-controller.kicad_pcb, flight-controller.kicad_sch, untitled.kicad_sch]
2026-04-04 fc with esp
    [BMS.kicad_sch, FC.kicad_sch, flight-controller.kicad_pcb, flight-controller.kicad_sch]
2026-04-10 reoriented parts
    [inverter_leg.kicad_sch, motor-driver.kicad_pcb, motor-driver_V0.0_bom.csv, motor-driver_V0.0_positions.csv, rp2350.kicad_sch]
2026-04-12 cleaned up the layout
    [BMS.kicad_sch, FC.kicad_sch, Sensors.kicad_sch, flight-controller.kicad_pcb, flight-controller.kicad_sch]
